vishwab0815/3D-glasses/docs/wiring_diagram.html

# Voice Glasses Wiring

XIAO ESP32-S3 + INMP441 microphone + MAX98357A amplifier + speaker, with the laptop server and Groq. Based on the firmware pin map and your photos from 3 November.

## 1. End-to-end flow

The glasses only capture and play sound; all understanding happens on the laptop and at Groq. The board and laptop must be on the same 2.4 GHz Wi-Fi.

## 2. Wiring diagram

Correct wiring Your wiring now (from photos)

Correct wiring. D1 and D2 are shared: each XIAO pin feeds both the mic and the amp. Only the mic uses 3.3 V; the amp uses 5 V; the speaker connects only to the amp's SPK + and SPK −.

3.3 V 5 V GND mic data (SD) bit clock (SCK / BCLK) word select (WS / LRC) speaker data (DIN)

## 3. Pin-by-pin checklist

Status comes from your photos and the board's tests on 3 November. "Not checked" means the photo couldn't show it; confirm with a multimeter on continuity (beep) mode.

From | To | What it carries | Status now
Mic VDD | XIAO 3V3 | Mic power | wired, not checked
Mic GND | XIAO GND | Ground | wired, not checked
Mic SD | XIAO D0 | Sound data to the board | wired, not checked
Mic WS | XIAO D2 (with amp LRC) | Word select | wired, not checked
Mic SCK | XIAO D1 (with amp BCLK) | Bit clock | not connected
Mic L/R | GND | Selects mic channel | likely not connected
Amp VIN | XIAO 5V | Amp power | not checked
Amp GND | XIAO GND | Ground | not checked
Amp BCLK | XIAO D1 | Bit clock | twisted joint
Amp LRC | XIAO D2 | Word select | twisted joint
Amp DIN | XIAO D3 | Speaker data | not checked
Amp GAIN, SD | nothing | Defaults: 9 dB gain, on | leave unconnected
Amp SPK + | Speaker red | Sound out | red unplugged
Amp SPK − | Speaker black | Sound out | black is on 3V

Real header order on the amp board: LRC, BCLK, DIN, GAIN, SD, GND, VIN. On the mic board: GND, VDD, SD on one side; L/R, WS, SCK on the other.

## 4. Rules that prevent damage

Speaker only on SPK + / SPK −Never connect a speaker wire to 3V, 5V or GND: it shorts the supply through the coil.

Mic on 3.3 V onlyThe INMP441 is a 3.3 V part; 5 V can destroy it.

Solder, don't twistTwisted joints work on the desk and fail when the hinge moves.

Battery to BAT padsA 3.7 V LiPo goes to the XIAO's BAT pads on the back, never to the 3V3 pin.

Unplug before rewiringRemove the USB cable before soldering or moving any wire.
