vishwab0815/3D-glasses/(commit log)

2026-11-03 first commit
    ESP32-S3 voice assistant for 3D-printed glasses: XIAO ESP32-S3 firmware,
    laptop server (Groq speech-to-text, chat, text-to-speech), device tools,
    hardware dimensions PDF and wiring diagram.
2026-11-03 Add full wiring to README
    Every connection pin by pin, links to the wiring diagram and dimensions PDF,
    damage-prevention rules (speaker only on SPK+/-, battery to BAT+), micdiag,
    clone instructions and download-timeout troubleshooting.
